jeronstone/enes100-otv/README.md

# Interstellar OTV Electronics Subsystem 

## Components

We use an **Arduino UNO** to control our OTV.  



Along with the Arduino, we use:  
**[1x Continuous servo motor](https://www.amazon.com/KOOKYE-360-Continuous-Rotation-Helicopter/dp/B019TOJPO4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)** move our OTV's arm up and down.  
**[1x Ultrasonic sensor](https://www.amazon.com/HC-SR04-Ultrasonic-Distance-Measuring-MEGA2560/dp/B088BT8CDW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)** to use in navigation.  
**[1x Reed switch](https://www.amazon.com/Magnetron-MagSwitch-Arduino-Digital-3-3V-5V/dp/B07MD9GFXN)** to detect magnetism.  
**[2x 12V DC motors](https://www.pololu.com/product/3491/specs)** for propulsion.  
**[1x L298N Dual HBridge Motorcontroller](https://www.amazon.com/Qunqi-2Packs-Controller-Stepper-Arduino/dp/B01M29YK5U)** to controller our 2 motors.  
For duty cycle detection, we will use **[brass wool](https://bluethundertechnologies.com/product/jbc-cl6210-brass-wool/)**.  

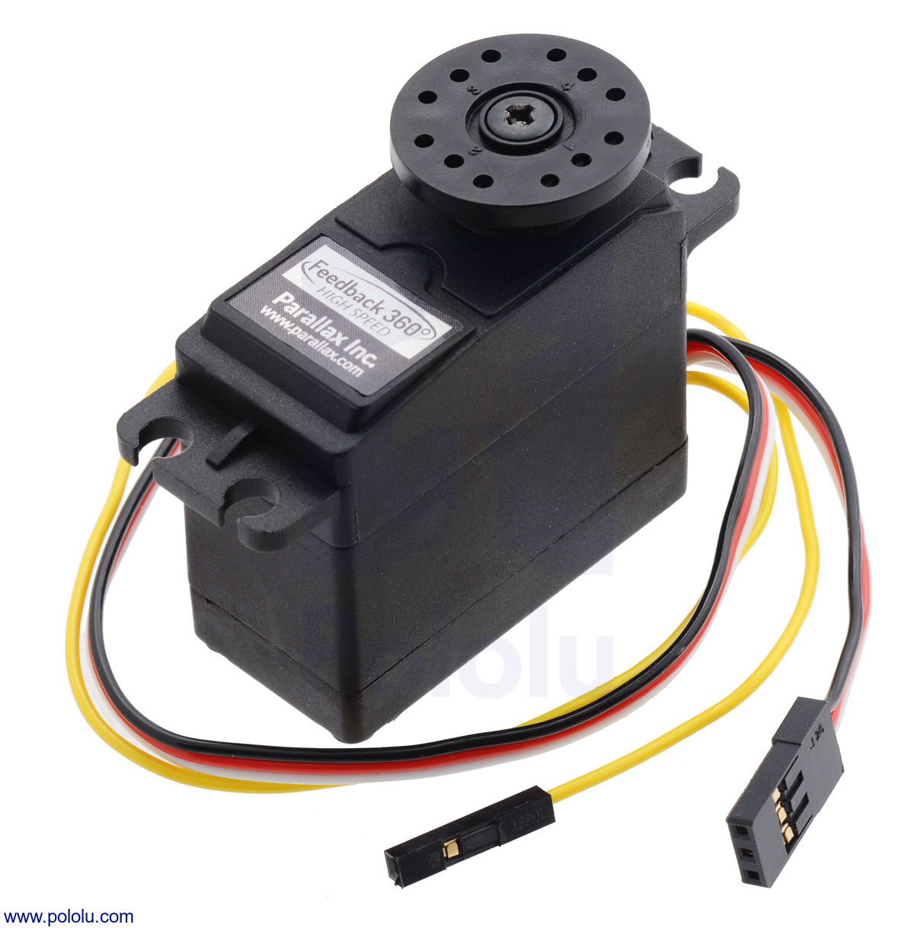
[picture p2: Images/servo.jpg]
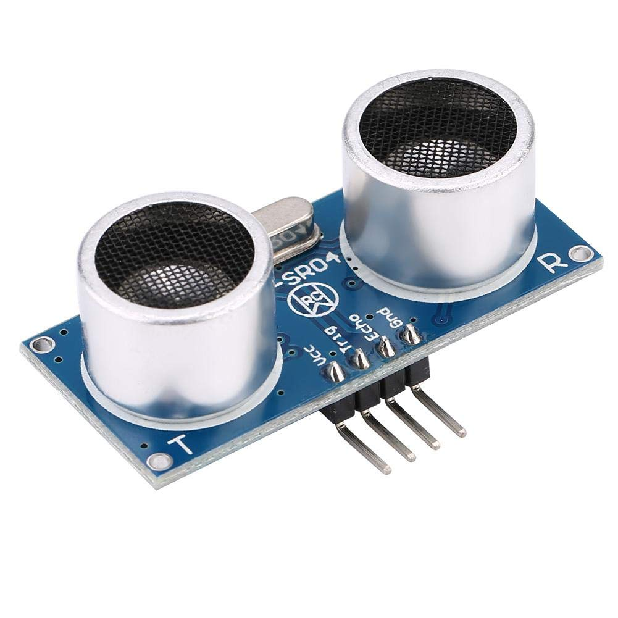
[picture p3: Images/ultrasonic.jpg]
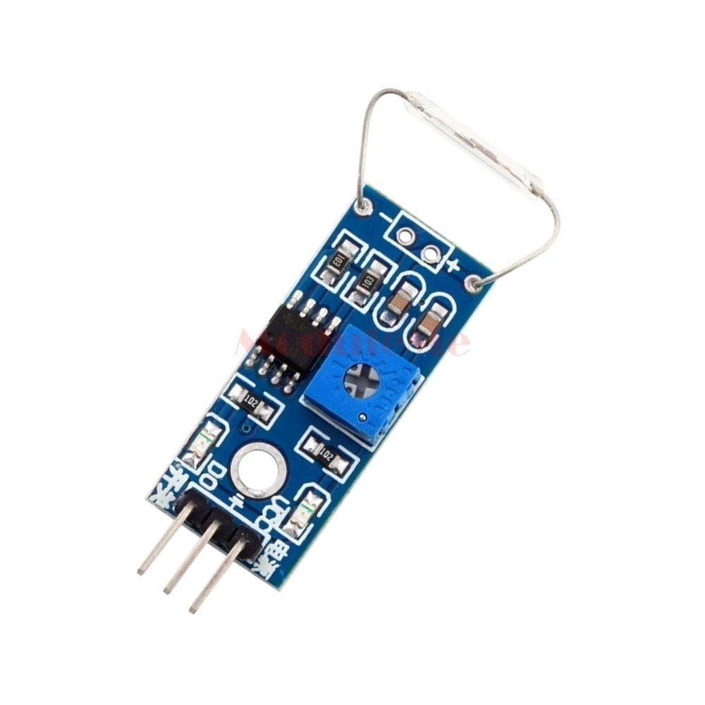
[picture p4: Images/reed.jpg]
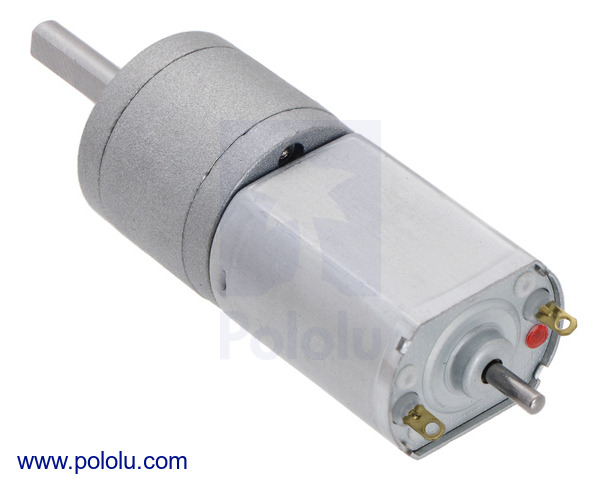
[picture p5: Images/motor.jpg]
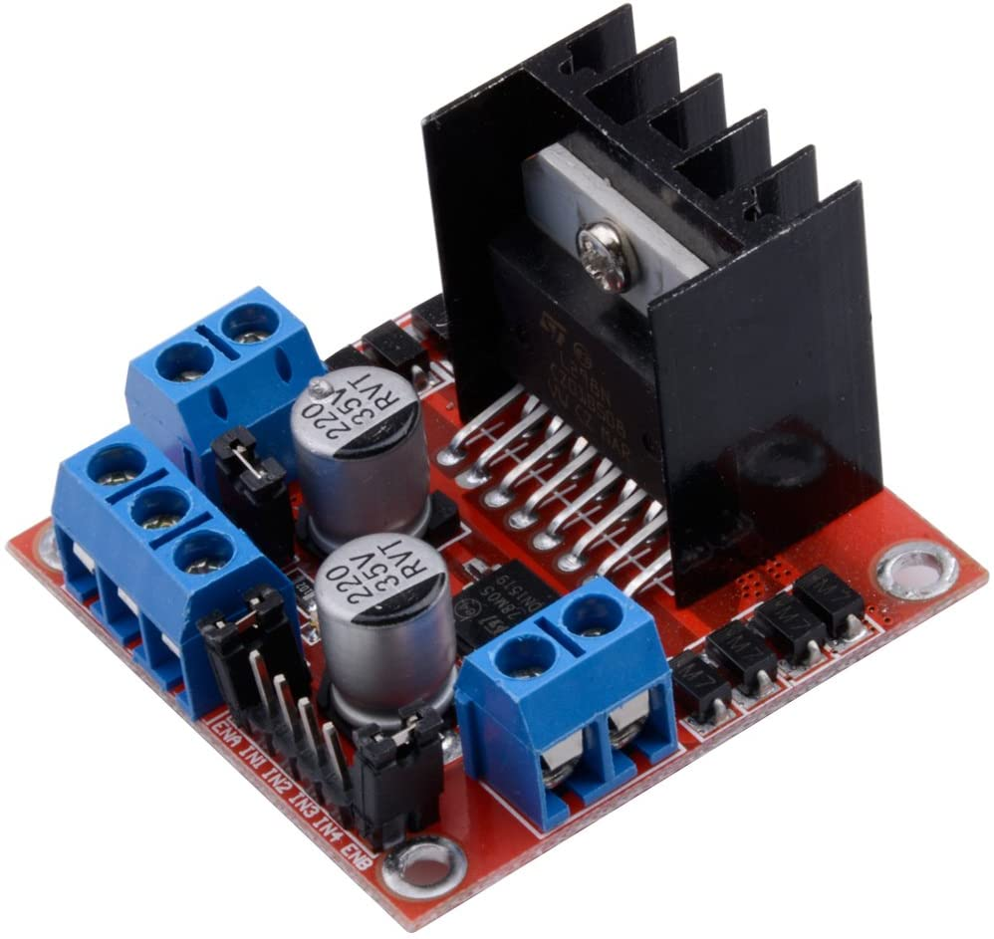
[picture p6: Images/motorcontrol.jpg]
      

## Battery/Power Details and Calculations  

To power our OTV, we decided to use a **[12V rechargable battery](https://www.amazon.com/Tenergy-Capacity-Rechargeable-Replacement-Equipments/dp/B077Y9HNTF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)**. This battery has a **[kill switch](https://www.digikey.com/en/products/detail/e-switch/RR511D1121/2116256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)** attached. The battery has a 2000mAh capacity and a recommended discharge rate of 2A.    

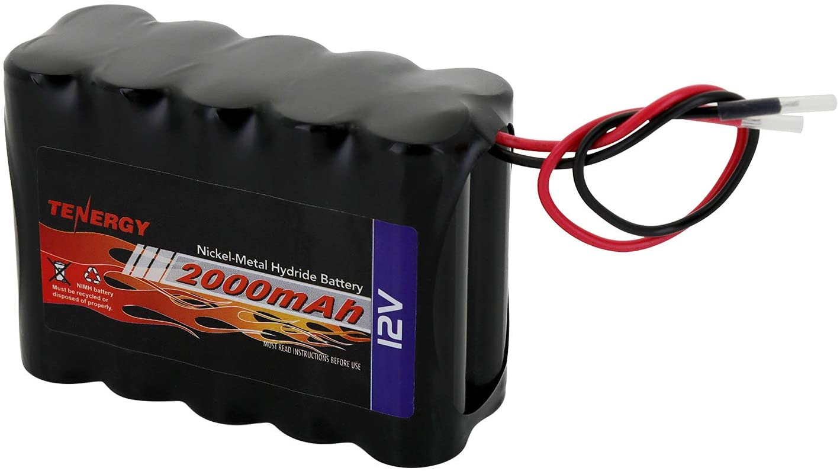
[picture p7: Images/battery.jpg]
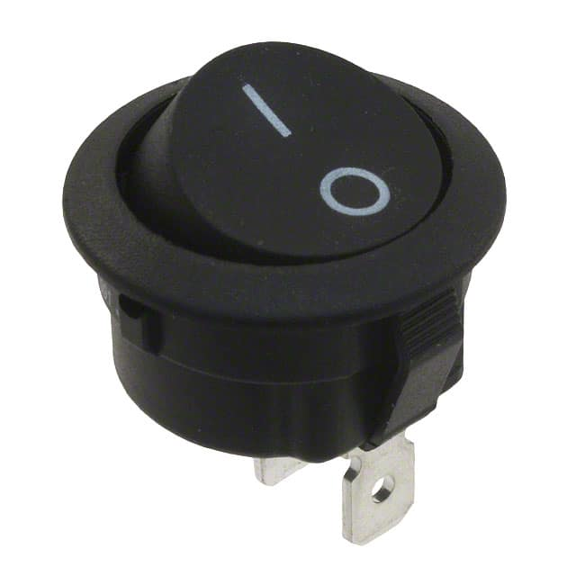
[picture p8: Images/killswitch.jpg]
 

### Calculations  

Our current draw calculations are as follows:  
Motors: Our calculated current draw for each motor is ~147.3 mA per motor, which is calculated based on our 18.7 Ncm operating torque. Using this torque and our 90 rpm operating speed gives us a wattage of 1.767 W, which diving by 12 V and converting from A to mA gives us an operating current draw of ~147.3 mA per motor, or 294.6 mA for both motors.   
Ultrasonic: 15 mA while operating. (Source: [link](https://randomnerdtutorials.com/complete-guide-for-ultrasonic-sensor-hc-sr04/)).  
Reed Switch: The reed switch's current draw is negligible, and the reed switch is only operating for a small part of our mission, so we will not include this in our calculating.   
Servo motor: The arm servo has an operating current draw of 100 mA, though it could fluctuate higher. (Source: [Manufacturers' Website](https://kookye.com/2016/01/01/kookye-servo-motor-metal-gear-360-degree-rotation/)).  
Motorcontroller: The L298N Dual HBridge uses 36 mA for functions not related to powering the motors themselves, according to [Banana Robotics](https://www.bananarobotics.com/shop/L298N-Dual-H-Bridge-Motor-Driver).  
WiFi Module: According to [source](https://www.instructables.com/ESP8266-Pro-Tips/#:~:text=An%20esp8266%20chip%20can%20draw,not%20be%20less%20than%20170mA.), the ESP8266 can draw up to 170 mA.  

The total current draw based on all components is ~615.6 mA.
Based on our battery's 2000mAh capacity, our OTV should be able to run for around 3.25 hours.  

### Power Modulation, Actuation Control  

We will modulate power to our propulsion motors using a L298N Dual HBridge motorcontroller, as stated above. This motor controller has a discharge rate to the motors of 2A, the same as our battery. The L298N will take a PWM signal from the Arduino to control the speed of the motors.
The arm servo's direction and speed will also be controlled using a PWN signal from the Arduino.  

## Ardunio Pinouts

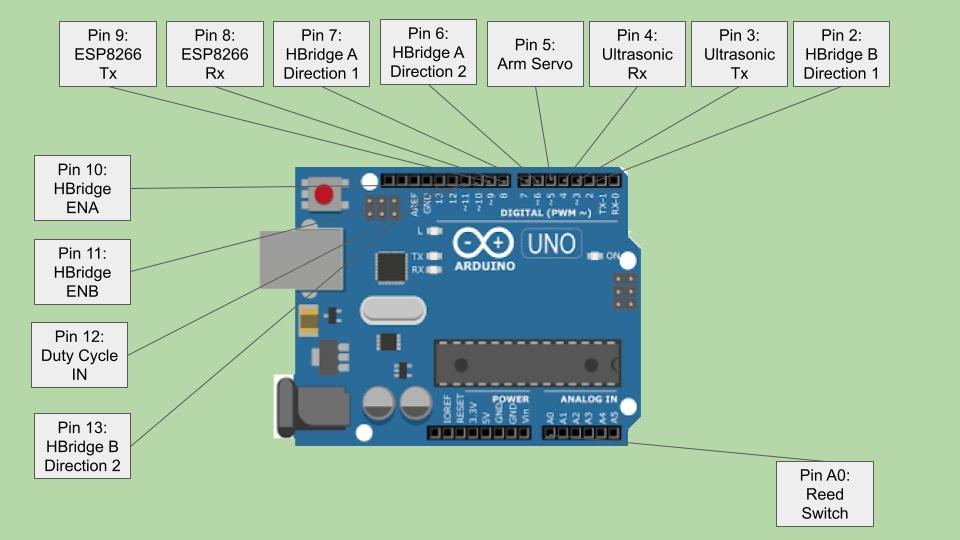
[picture p9: Images/ARDUINOPINOUT.jpg]
Ardunio Pinout Chart
  

2: Propulsion: Direction B 1  
3: Ultrasonic TX  
4: Ultrasonic RX  
5: Arm Servo Signal  
6: Propulsion: Direction A 2  
7: Propulsion: Direction A 1  
8: WiFi RX  
9: WiFi TX  
10: Propulsion: ENA   
11: Propulsion: ENB  
12: Duty Cycle  
13: Propulsion: Direction B 2  
A0: Reed Switch (read as digital input in code)  

**HBRIDGE**: IN1 = DirA 1; IN2 = DirA 2; IN3 = DirB 1; IN4 = DirB 2  
OUT 1-4 to motors  

## Circuit Schematic

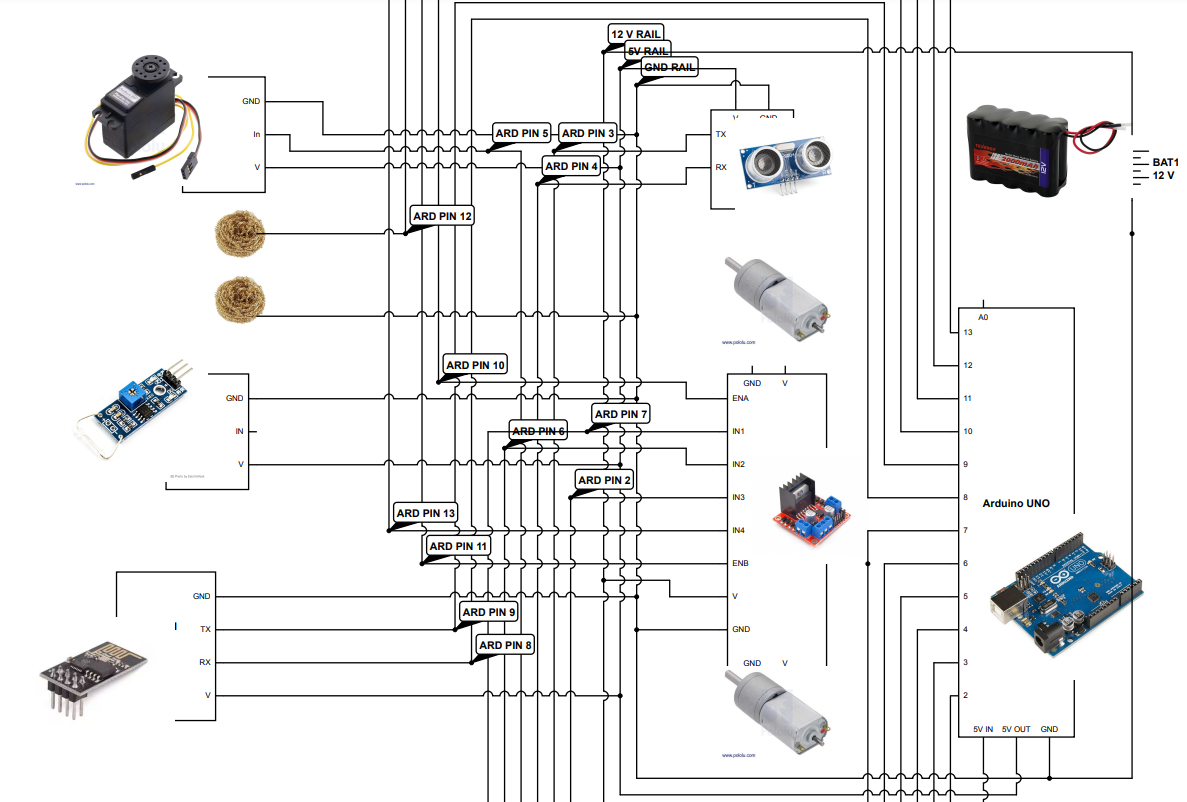
[picture p10: Images/circuitschem.png]
OTV Circuit Schematic


The battery is connected to the breadboard, creating a 12V rail. Ardunio Vin will connect to this rail. The other breadboard rail will be 5V from Ardunio's 5V out.  

**The sensors/actuators connect to the rails as follows:**  
Ultrasonic Sensor to 5V rail.  
Arm Servo to 5V rail.  
WiFi module to 5V rail.  
Reed Switch Module to 5V rail.  
Dual HBridge Motorcontroller to 12V rail.  
All of these components will also be connected to (any) ground rail.
