jeronstone/enes100-otv/Audio/readme.txt

Code that would run on another arduino and play the interstellar theme while we did the mission.
Never came to fruition smh my head.
