jeronstone/enes100-otv/Images/brass.jpg

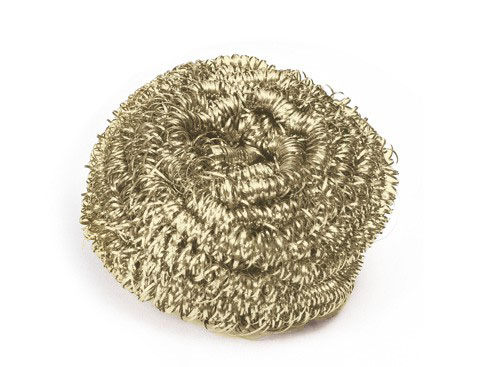
Images/brass.jpg
