jeronstone/enes100-otv/(commit log)

2022-03-29 post arm servo testing
    arm servo testing works after moving constructor to begin method
2022-03-31 Post prop and comm test
2022-04-18 consts
    updated header file to have correct const values
    [ArmServo.h]
2022-04-19 test commit
    test commit to see if git is now correctly attributing
    [TestTankComm.ino]
2022-04-21 4/21/22 class
    doMission not including servo works : )
    test nav next
2022-05-03 5/3/22
    fixed servo issues
    attaches and detaches within run method
    removed test ino file, may re-add later
    [ArmServo.cpp, ArmServo.h, Main.ino, Propulsion.cpp, Sensors.cpp]
2022-05-13 updated readme
    current draw, otv time
